th0mpy/simple_stepper_motor_analyzer/kicad/README.md

# IMPORTANT: Do not use the latest files in this directory to build your analyzer. Instead, use the latest hardware release in this github repository. The latest files can be a work in progress toward the next stable release.
