th0mpy/simple_stepper_motor_analyzer/kicad/stepper_analyzer.kicad_pcb

## KiCad design kicad/stepper_analyzer.kicad_pcb (2022-12-17)

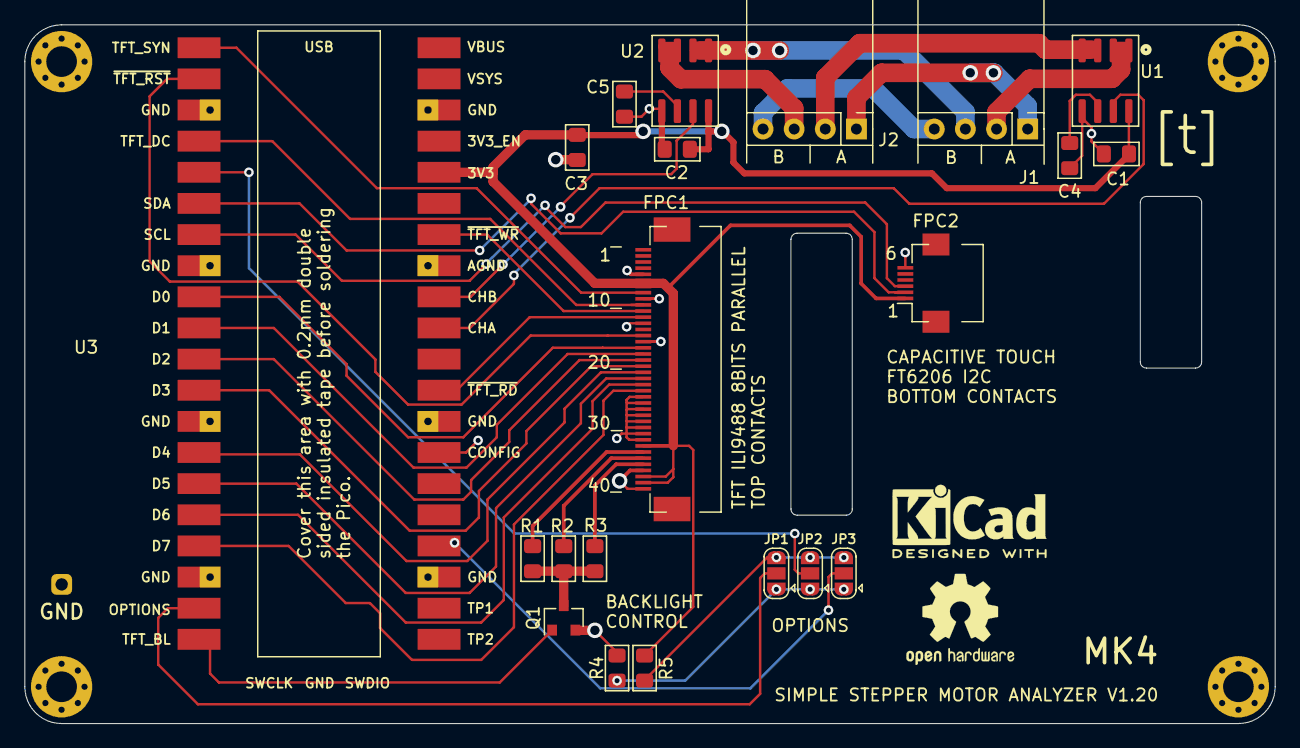
[picture p1: board stepper_analyzer.kicad_pcb from above]

Board: 2 copper layers, 102.0 x 57.0 mm, 28 parts (1 on the bottom side), 37 nets.

Parts:
C1, C2: 0.1u; C_0805_2012Metric_Pad1.15x1.40mm_HandSolder
C3: 10u; C_0805_2012Metric_Pad1.15x1.40mm_HandSolder
C4: 1nf; C_0805_2012Metric_Pad1.15x1.40mm_HandSolder
C5: DNP; C_0805_2012Metric_Pad1.15x1.40mm_HandSolder
FPC1: Connector_Conn_01x40_Female; JUSHUO-AFC07-S40ECC-00_40P_05mm_flipped
FPC2: FPC connector, 6 pins, 0.5mm, BOTTOM contacts; JUSHUO-AFC01-S06FCC-00_6p_05mm
H1, H2, H3, H4: MountingHole; MountingHole_2.5mm_Pad_Via
J1, J2: Connector_Conn_01x04_Male; connector_4pins_horizontal
JP1: OPTION1; SolderJumper-3_P1.3mm_Open_RoundedPad1.0x1.5mm
JP2: OPTION2; SolderJumper-3_P1.3mm_Open_RoundedPad1.0x1.5mm
JP3: OPTION3; SolderJumper-3_P1.3mm_Open_RoundedPad1.0x1.5mm
LOGO1: Logo_Open_Hardware_Small; OSHW-Logo2_9.8x8mm_SilkScreen
M1: Motor; null_footprint
Q1: AO3400A; SOT-23
R1, R2, R3: 8R2; R_0805_2012Metric_Pad1.15x1.40mm_HandSolder
R4: 1K; R_0805_2012Metric_Pad1.15x1.40mm_HandSolder
R5: 1K; R_0805_2012Metric_Pad1.15x1.40mm_HandSolder_no_3d
TP3: TestPoint; testpoint_double_side
U1, U2: (CURRENT SENSOR); SOIC-8_3.9x4.9mm_P1.27mm
U3: Pico; Pico_smd_dedicated

Connections:
+3V3: C1.2, C2.2, C3.2, FPC1.6, FPC1.7, FPC1.33, FPC1.38, FPC1.39, FPC2.1, R5.2, U1.8, U2.8, U3.36
/CHA: U1.7, U3.31
/CHB: U2.7, U3.32
/D0: FPC1.17, U3.9
/D1: FPC1.18, U3.10
/D2: FPC1.19, U3.11
/D3: FPC1.20, U3.12
/D4: FPC1.21, U3.14
/D5: FPC1.22, U3.15
/D6: FPC1.23, U3.16
/D7: FPC1.24, U3.17
/OPTION1: JP1.2, U3.19
/OPTION2: JP2.2, U3.5
/OPTION3: JP3.2, U3.24
/SCL: FPC2.3, U3.7
/SDA: FPC2.2, U3.6
/TFT_BL: Q1.1, U3.20
/TFT_DC: FPC1.10, U3.4
/TFT_SYN: FPC1.8, U3.1
/~TFT_RD: FPC1.12, U3.29
/~TFT_RST: FPC1.15, U3.2
/~TFT_WR: FPC1.11, U3.34
GND: C1.1, C2.1, C3.1, C4.1, C5.1, FPC1.5, FPC1.9, FPC1.13, FPC1.16, FPC1.25, FPC1.26, FPC1.27, FPC1.28, FPC1.29, FPC1.30, FPC1.31, FPC1.32, FPC1.37, FPC1.40, FPC2.6, Q1.2, R4.2, TP3.1, U1.5, U2.5, U3.3, U3.8, U3.13, U3.18, U3.23, U3.27, U3.28, U3.33, U3.38
unnamed: C4.2, U1.6
unnamed: C5.2, U2.6
unnamed: FPC1.34, R1.2
unnamed: FPC1.35, R2.2
unnamed: FPC1.36, R3.2
unnamed: J1.1, J2.1
unnamed: J1.2, U1.1, U1.2
unnamed: J1.3, U2.1, U2.2
unnamed: J1.4, J2.4
unnamed: J2.2, U1.3, U1.4
unnamed: J2.3, U2.3, U2.4
unnamed: JP1.1, JP2.1, JP3.1, R4.1
unnamed: JP1.3, JP2.3, JP3.3, R5.1
unnamed: Q1.3, R1.1, R2.1, R3.1
